brengi/MG-Lab/README.md

# MG-Lab
Producción del Laboratorio Mario Gattafoni

## Objetivos ##
El MG-Lab trabaja con alumnos de colegios técnicos secundarios, bajo
el régimen de práctica profesional supervisada.
Se utilizan tecnologías abiertas y se publican los resultados de cada
práctica.

## Responsables ##
El plantel estable del laboratorio esta formado por Omar Milano y Diego Brengi.

## Nombre del laboratorio ##
El laboratorio se bautiza con ese nombre en honor a Mario Gattafoni quien fue profesor
de Omar y Diego en la secundaria y en la universidad, y dedicó su vida a 
la educación técnica secundaria y universitaria.

## Grupos MG-LAB 2019

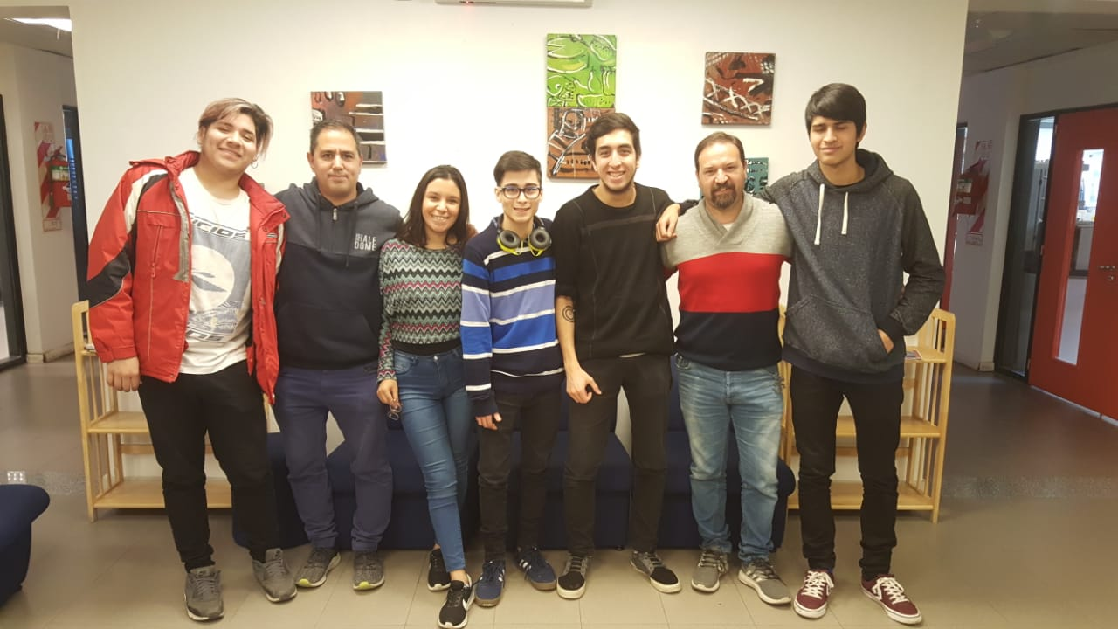
[picture p1: doc/fotos_grupales/2019b.jpg]
Grupo2019b Grupo 2019b

De izquierda a derecha:.

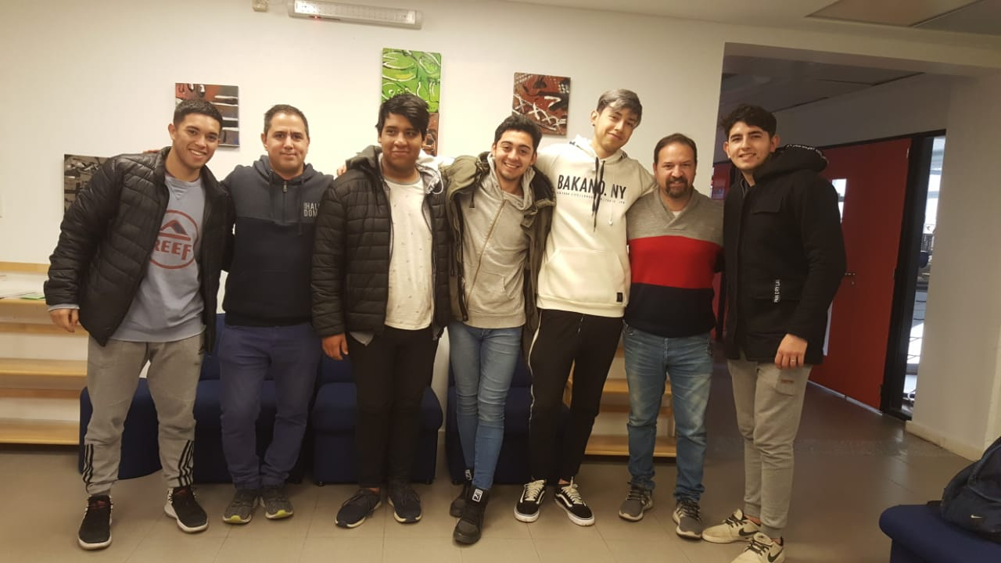
[picture p2: doc/fotos_grupales/2019a.jpg]
Grupo2019a Grupo 2019a

De izquierda a derecha:.

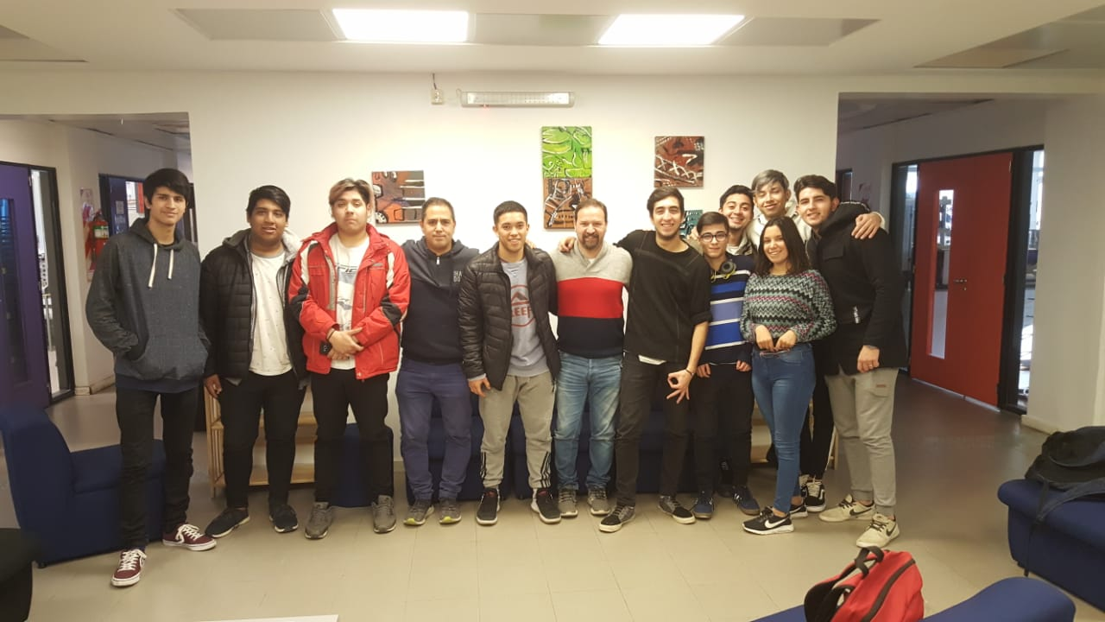
[picture p3: doc/fotos_grupales/2019ab.jpg]
Grupo2019ab Grupo 2019ab

De izquierda a derecha:.

## Grupos MG-LAB 2018

Grupo2018 Grupo 2018
De izquierda a derecha: Omar Milano, ... y Diego Brengi.

## Grupos MG-LAB 2017

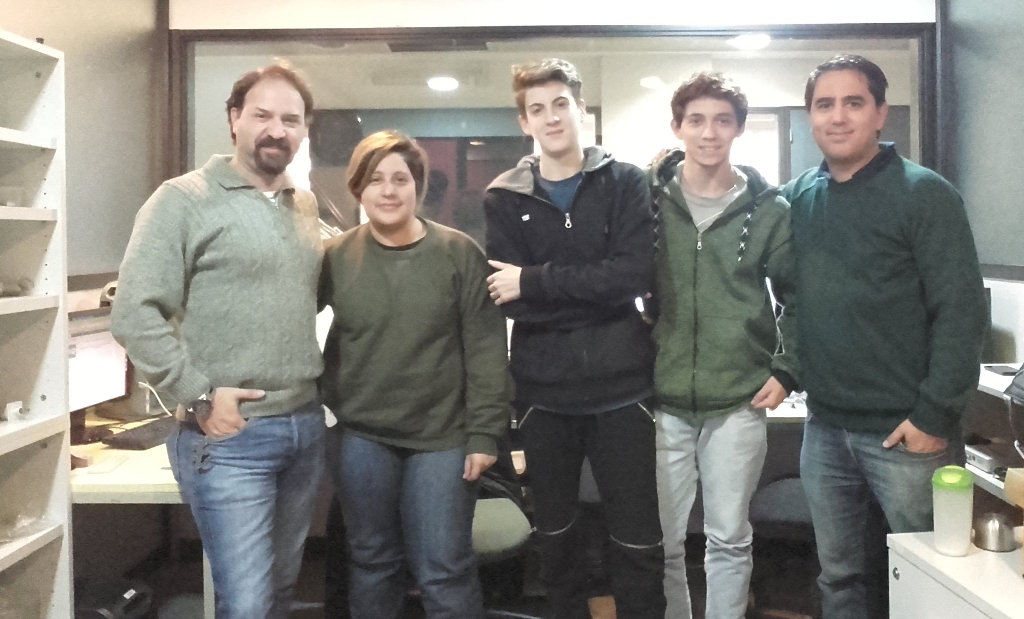
[picture p4: doc/fotos_grupales/MGLAB_Grupo3.jpg]
Grupo3 Grupo 3

De izquierda a derecha: Omar Milano, Delfina Gonzalez, Gonzalo Daniel Magdalena, Nelson Saade y Diego Brengi.

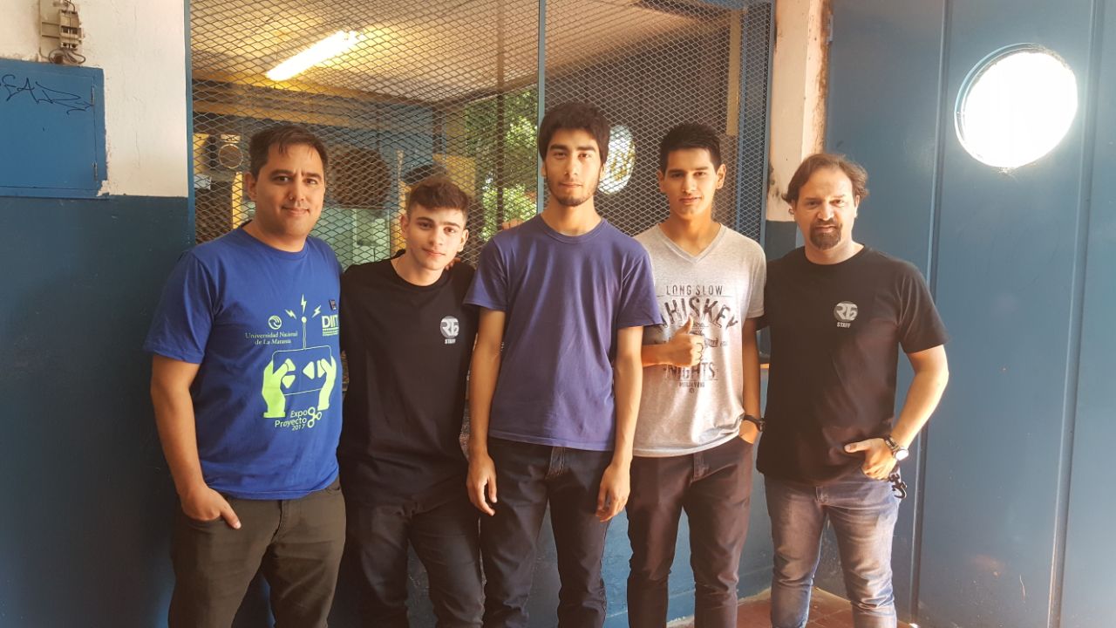
[picture p5: doc/fotos_grupales/MGLAB_Grupo4_2017B.jpg]
Grupo4 Grupo 4

De izquierda a derecha: Diego Brengi, XX1, XX2, XX3 y Omar Milano.

## Grupos MG-LAB 2016

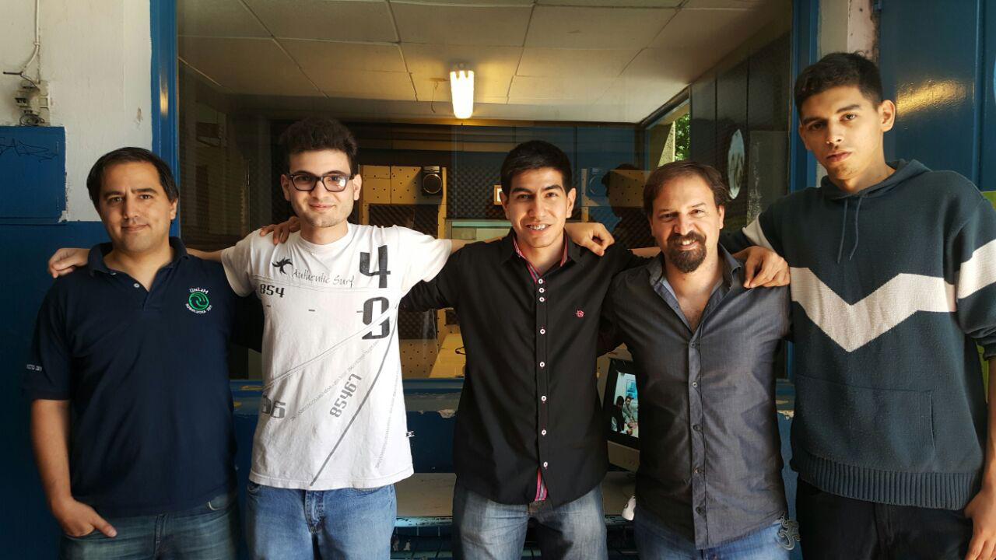
[picture p6: doc/fotos_grupales/MGLAB_Grupo1.jpg]
Grupo1 Grupo 1

De izquierda a derecha: Diego Brengi, Juan Ignacio
Napolillo, Nicolas David Luna, Omar Milano y Leonel Gabriel Costa.

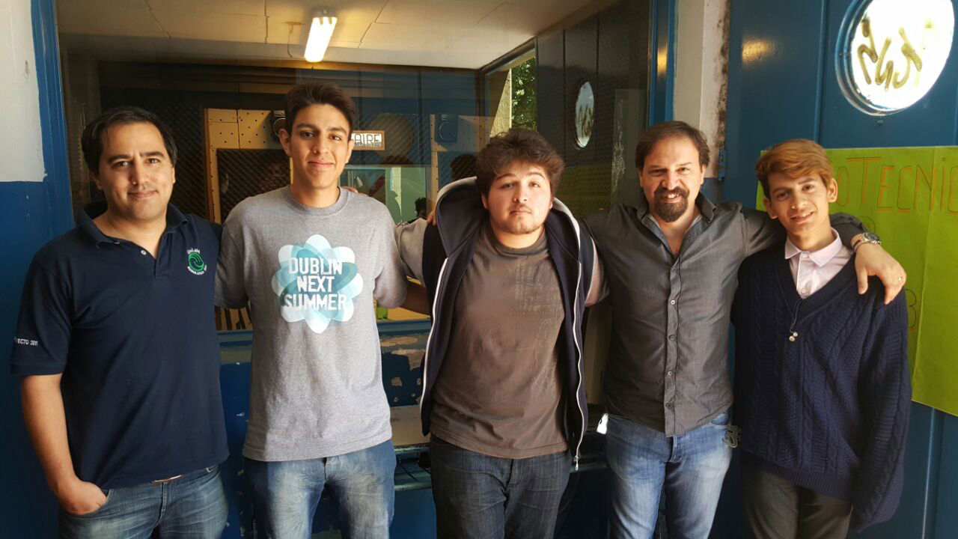
[picture p7: doc/fotos_grupales/MGLAB_Grupo2.jpg]
Grupo2 Grupo 2

De izquierda a derecha: Diego Brengi, Alejandro Franco, Fernando Flores, Omar Milano y Fernando Sosa.
