brengi/MG-Lab/Arduino_SumoRobot/README.md

# SHIELD DE ARDUINO PARA ROBOT SUMO #
 
RESPONSABLE:  
 
## ACTIVIDAD ##
Realizar un una implementación con Arduino que permita controlar un robot 
sumo. Primero con módulos comerciales y cableado y luego si es posible, diseñar uno o 
más shields usando KiCad.
 
## PAUTAS ##
  *  Manejo de dos motores en ambos sentidos, con relés. 
  * Manejo de 4 sensores de línea infrarrojos. 
  * Entrada de dos pulsadores. 
  * Manejo de un relé o salida transistor adicional y posibilidad de manejar un servo 
(puede ser todo el mismo pin). 
  * Posibilidad de conectar uno o dos módulos de ultrasonido FR04. 
  * Considerar alimentación de 12 Volts. 
  * Considerar protecciones en el manejo de potencia: Motores, bobinas de relés y 
servos. 
  * PCBs de simple capa (que se puedan fabricar con plancha). Pueden ser varios 
shields apilables, pero que puedan trabajar todos juntos.  Puede ocupar más área
que el arduino.
