brengi/MG-Lab/Boton_Auxilio/Diagrama_en_bloques/Diagrama_en_bloques.png

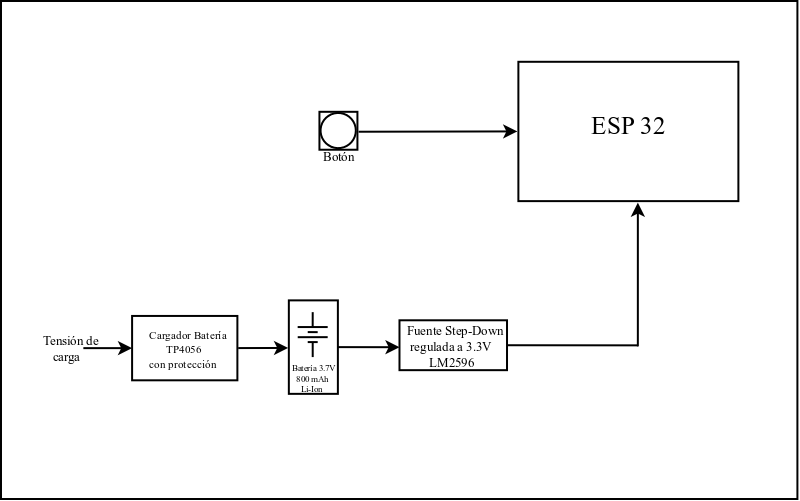
Boton_Auxilio/Diagrama_en_bloques/Diagrama_en_bloques.png
