brengi/MG-Lab/Rolador/PLACA_ROLADOR_Alimentacion/serigrafia.pdf

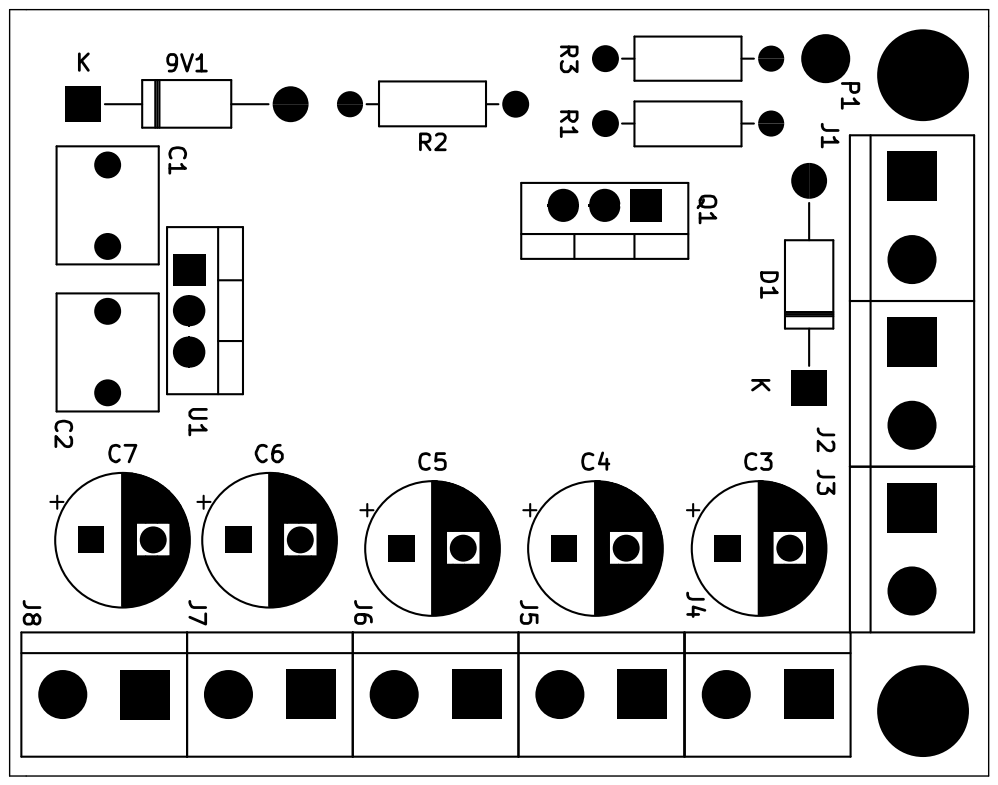
[picture p18: page 1]
