brengi/MG-Lab/(list of files, drawings)

Other design files:
Rolador/PLACA_ROLADOR_Alimentacion/placa de tension rolador.dsn
