brengi/MG-Lab/Rolador/PLACA_ROLADOR_Alimentacion/placa de tension rolador.kicad_pcb

## KiCad design Rolador/PLACA_ROLADOR_Alimentacion/placa de tension rolador.kicad_pcb (2019-07-31)

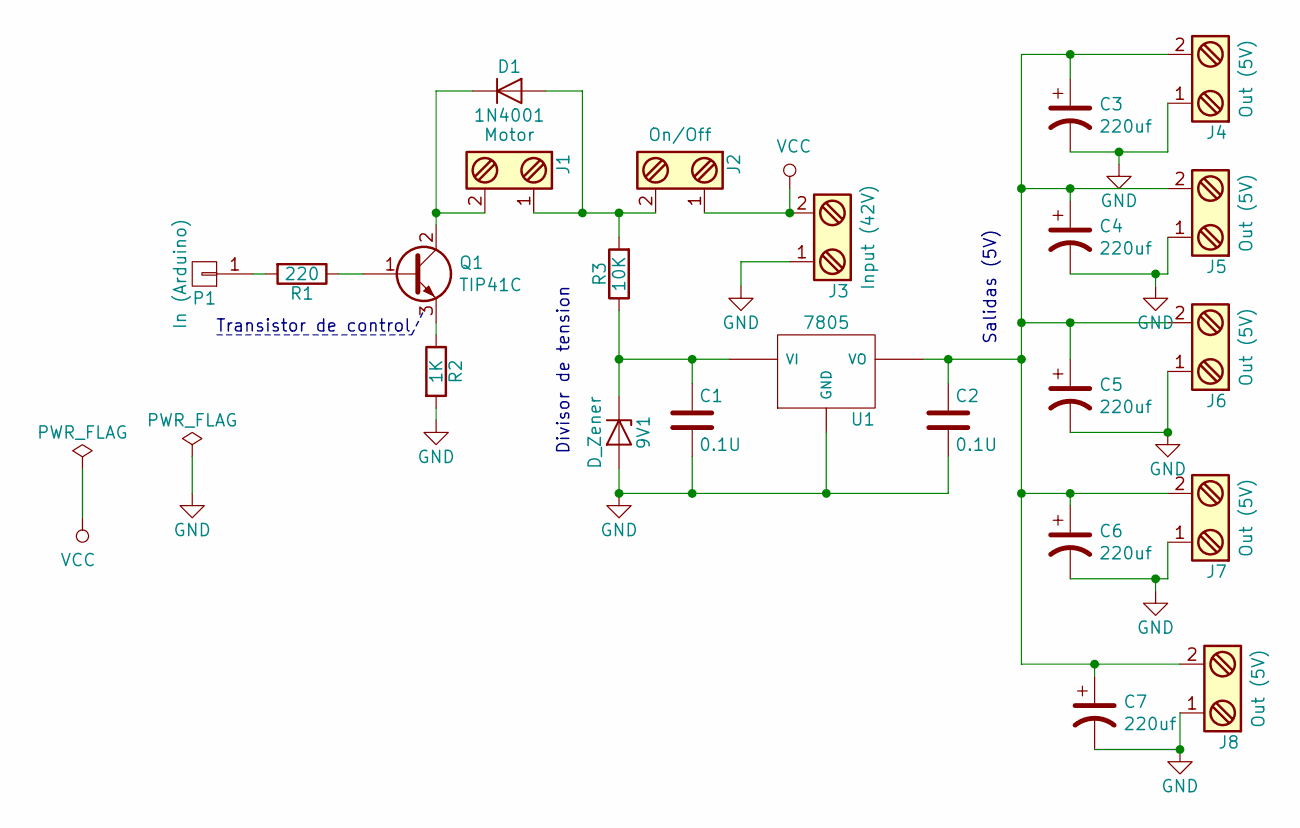
[picture p19: schematic placa de tension rolador.sch, Placa de alimentacion rolador]

Parts:
9V1: D_Zener; D_DO-41_SOD81_P12.70mm_Horizontal
C1, C2: 0.1U; C_Rect_L7.0mm_W6.0mm_P5.00mm
C3, C4, C5, C6, C7: 220uf; CP_Radial_D8.0mm_P3.80mm
D1: 1N4001; D_DO-41_SOD81_P12.70mm_Horizontal
J1: Motor; TerminalBlock_bornier-2_P5.08mm
J2: On/Off; TerminalBlock_bornier-2_P5.08mm
J3: Input (42V); TerminalBlock_bornier-2_P5.08mm
J4, J5, J6, J7, J8: Out (5V); TerminalBlock_bornier-2_P5.08mm
P1: In (Arduino); Pin_D0.7mm_L6.5mm_W1.8mm_FlatFork
Q1: TIP41C; TO-220-3_Vertical
R1: 220; R_Axial_DIN0207_L6.3mm_D2.5mm_P10.16mm_Horizontal
R2: 1K; R_Axial_DIN0207_L6.3mm_D2.5mm_P10.16mm_Horizontal
R3: 10K; R_Axial_DIN0207_L6.3mm_D2.5mm_P10.16mm_Horizontal
U1: 7805; TO-220-3_Vertical

Connections:
GND: 9V1.2 (A), C1.2, C2.2, C3.2, C4.2, C5.2, C6.2, C7.2, J3.1, J4.1, J5.1, J6.1, J7.1, J8.1, R2.2, U1.2 (GND)
unnamed: 9V1.1 (K), C1.1, R3.1, U1.1 (VI)
unnamed: C2.1, C3.1, C4.1, C5.1, C6.1, C7.1, J4.2, J5.2, J6.2, J7.2, J8.2, U1.3 (VO)
unnamed: D1.1 (K), J1.2, Q1.2 (C)
unnamed: D1.2 (A), J1.1, J2.2, R3.2
unnamed: P1.1, R1.2
unnamed: Q1.1 (B), R1.1
unnamed: Q1.3 (E), R2.1
VCC: J2.1, J3.2

Notes on the sheet:
Transistor de control
Divisor de tension
Salidas (5V)

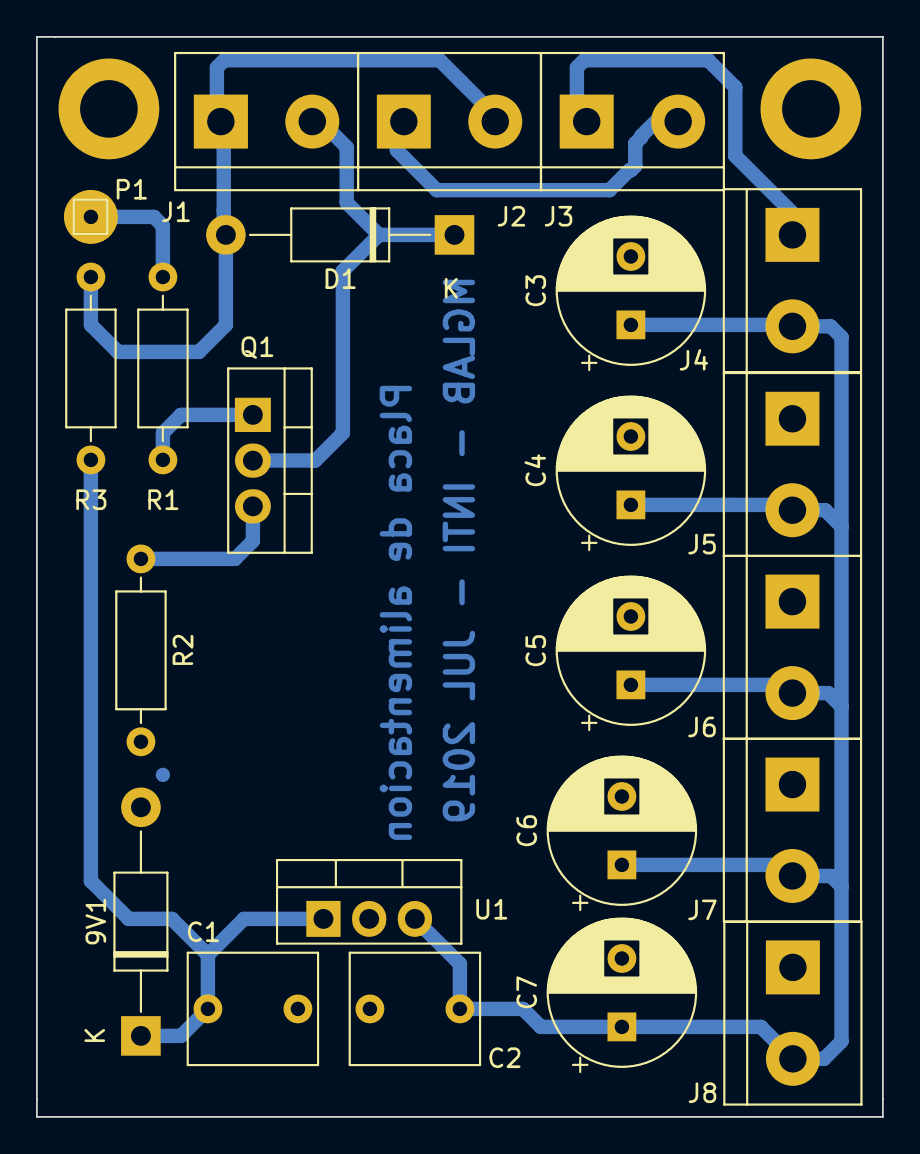
[picture p20: board placa de tension rolador.kicad_pcb from above]

Board: 2 copper layers, 47.0 x 60.0 mm, 25 parts (0 on the bottom side), 9 nets.

Other parts of the board:
H1, H2: .; MountingHole_3.2mm_M3_DIN965_Pad
