brengi/MG-Lab/Arduino_SumoRobot/sumo.kicad_pcb

## KiCad design Arduino_SumoRobot/sumo.kicad_pcb (2016-12-20)

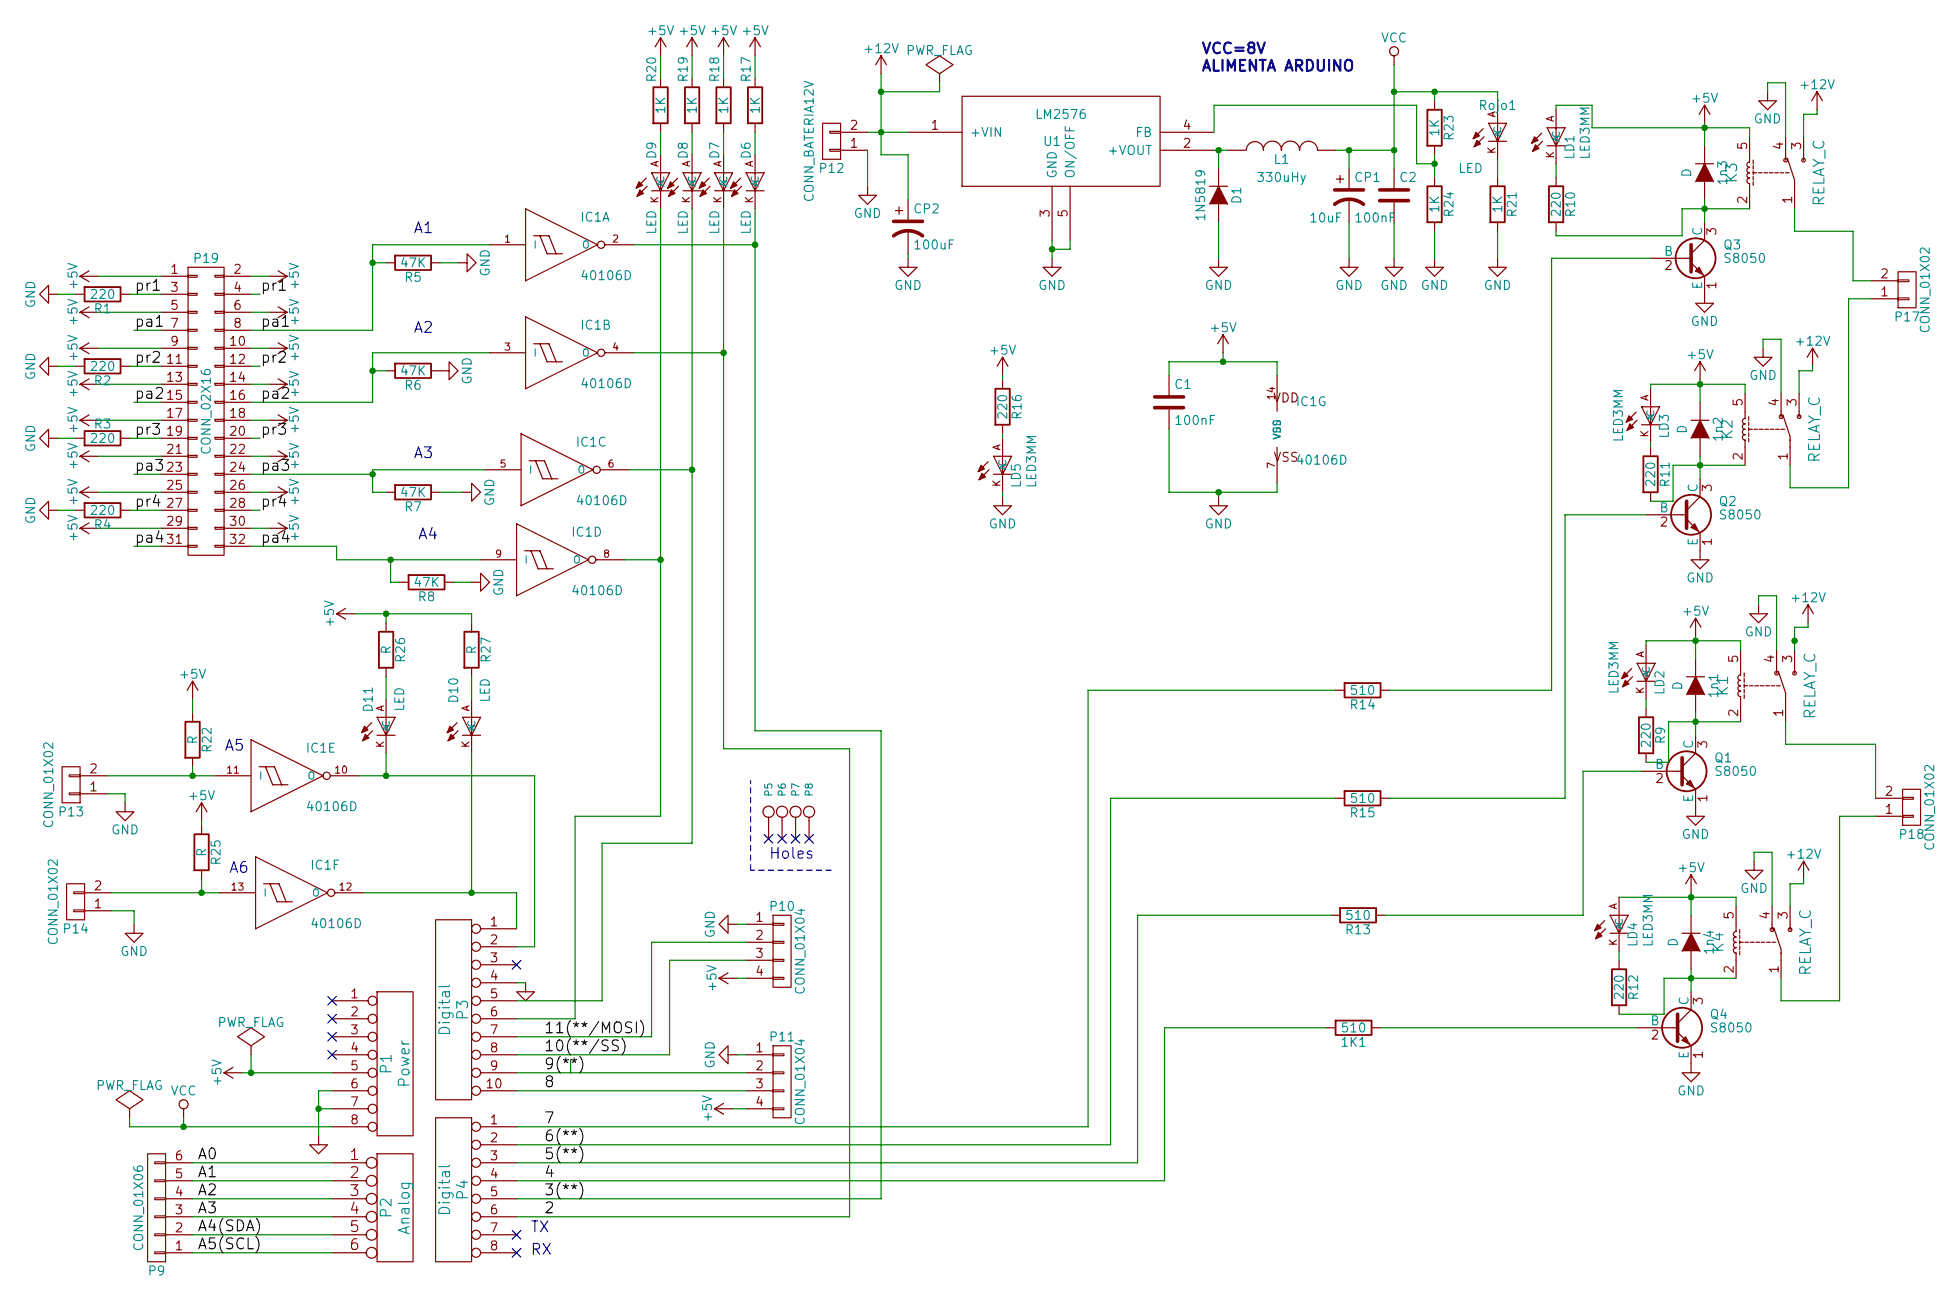
[picture p21: schematic sumo.sch]

Parts:
1K1: 510; Resistor_Horizontal_RM7mm
1n1, 1n2, 1n3, 1n4: D; Diode_DO-41_SOD81_Horizontal_RM10
C1, C2: 100nF; C_Rect_L7_W6_P5
CP1: 10uF; C_Radial_D6.3_L11.2_P2.5
CP2: 100uF; C_Radial_D6.3_L11.2_P2.5
D1: 1N5819; Diode_DO-41_SOD81_Horizontal_RM10
D6, D7, D8, D9, D10, D11: LED; led-LED3MM
IC1: 40106D; DIP-14_W7.62mm_LongPads
K1, K2, K3, K4: RELAY_C; Relay_SANYOU_SRD_Series_Form_C
L1: 330uHy; INDUCTOR_V
LD1, LD2, LD3, LD4, LD5: LED3MM; led-LED3MM
P1: Power; Socket_Strip_Arduino_1x08
P2: Analog; Socket_Strip_Arduino_1x06
P3: Digital; Socket_Strip_Arduino_1x10
P4: Digital; Socket_Strip_Arduino_1x08
P5, P6, P7, P8: CONN_1; Arduino_1pin
P9: CONN_01X06; Pin_Header_Straight_1x06
P10, P11: CONN_01X04; Pin_Header_Straight_1x04
P12: CONN_BATERIA12V; bornier2
P13, P14, P17, P18: CONN_01X02; bornier2
P19: CONN_02X16; Pin_Header_Straight_2x16
Q1, Q2, Q3, Q4: S8050; TO-92_Rugged
R1, R2, R3, R4, R9, R10, R11, R12, R16: 220; Resistor_Horizontal_RM7mm
R5, R6, R7, R8: 47K; Resistor_Horizontal_RM7mm
R13, R14, R15: 510; Resistor_Horizontal_RM7mm
R17, R18, R19, R20, R21, R23, R24: 1K; Resistor_Horizontal_RM7mm
R22, R25, R26, R27: R; Resistor_Horizontal_RM7mm
Rojo1: LED; led-LED3MM
U1: LM2576; TO220-51

Connections:
+5V: 1n1.1 (K), 1n2.1 (K), 1n3.1 (K), 1n4.1 (K), C1.1, IC1.14 (VDD), K1.5, K2.5, K3.5, K4.5, LD1.A, LD2.A, LD3.A, LD4.A, P1.5, P10.4, P11.4, P19.1, P19.2, P19.5, P19.6, P19.9, P19.10, P19.13, P19.14, P19.17, P19.18, P19.21, P19.22, P19.25, P19.26, P19.29, P19.30, R16.1, R17.1, R18.1, R19.1, R20.1, R22.1, R25.1, R26.1, R27.1
+12V: CP2.1, K1.3, K2.3, K3.3, K4.3, P12.2, U1.1 (+VIN)
/2: D7.K (C), IC1.4 (O), P4.6
/3(**): D6.K (C), IC1.2 (O), P4.5
/4: 1K1.2, P4.4
/5(**): P4.3, R13.2
/6(**): P4.2, R15.2
/7: P4.1, R14.2
/8: P3.10, P11.3
/9(**): P3.9, P11.2
/10(**/SS): P3.8, P10.3
/11(**/MOSI): P3.7, P10.2
/A0: P2.1, P9.6
/A1: P2.2, P9.5
/A2: P2.3, P9.4
/A3: P2.4, P9.3
/A4(SDA): P2.5, P9.2
/A5(SCL): P2.6, P9.1
/pa1: IC1.1 (I), P19.7, P19.8, R5.2
/pa2: IC1.3 (I), P19.15, P19.16, R6.2
/pa3: IC1.5 (I), P19.23, P19.24, R7.2
/pa4: IC1.9 (I), P19.31, P19.32, R8.2
/pr1: P19.3, P19.4, R1.1
/pr2: P19.11, P19.12, R2.1
/pr3: P19.19, P19.20, R3.1
/pr4: P19.27, P19.28, R4.1
GND: C1.2, C2.2, CP1.2, CP2.2, D1.2 (A), IC1.7 (VSS), K1.4, K2.4, K3.4, K4.4, LD5.K (C), P1.6, P1.7, P3.4, P10.1, P11.1, P12.1, P13.1, P14.1, Q1.1 (E), Q2.1 (E), Q3.1 (E), Q4.1 (E), R1.2, R2.2, R3.2, R4.2, R5.1, R6.1, R7.1, R8.1, R21.2, R24.2, U1.3 (GND), U1.5 (ON/OFF)
unnamed: 1K1.1, Q4.2 (B)
unnamed: 1n1.2 (A), K1.2, Q1.3 (C), R9.2
unnamed: 1n2.2 (A), K2.2, Q2.3 (C), R11.2
unnamed: 1n3.2 (A), K3.2, Q3.3 (C), R10.2
unnamed: 1n4.2 (A), K4.2, Q4.3 (C), R12.2
unnamed: D1.1 (K), L1.1, U1.2 (+VOUT)
unnamed: D6.A, R17.2
unnamed: D7.A, R18.2
unnamed: D8.A, R19.2
unnamed: D8.K (C), IC1.6 (O), P3.5
unnamed: D9.A, R20.2
unnamed: D9.K (C), IC1.8 (O), P3.6
unnamed: D10.A, R27.2
unnamed: D10.K (C), IC1.12 (O), P3.1
unnamed: D11.A, R26.2
unnamed: D11.K (C), IC1.10 (O), P3.2
unnamed: IC1.11 (I), P13.2, R22.2
unnamed: IC1.13 (I), P14.2, R25.2
unnamed: K1.1, P18.2
unnamed: K2.1, P17.1
unnamed: K3.1, P17.2
unnamed: K4.1, P18.1
unnamed: LD1.K (C), R10.1
unnamed: LD2.K (C), R9.1
unnamed: LD3.K (C), R11.1
unnamed: LD4.K (C), R12.1
unnamed: LD5.A, R16.2
unnamed: Q1.2 (B), R13.1
unnamed: Q2.2 (B), R15.1
unnamed: Q3.2 (B), R14.1
unnamed: R21.1, Rojo1.K (C)
unnamed: R23.2, R24.1, U1.4 (FB)
VCC: C2.1, CP1.1, L1.2, P1.8, R23.1, Rojo1.A

Notes on the sheet:
Holes
VCC=8V ALIMENTA ARDUINO

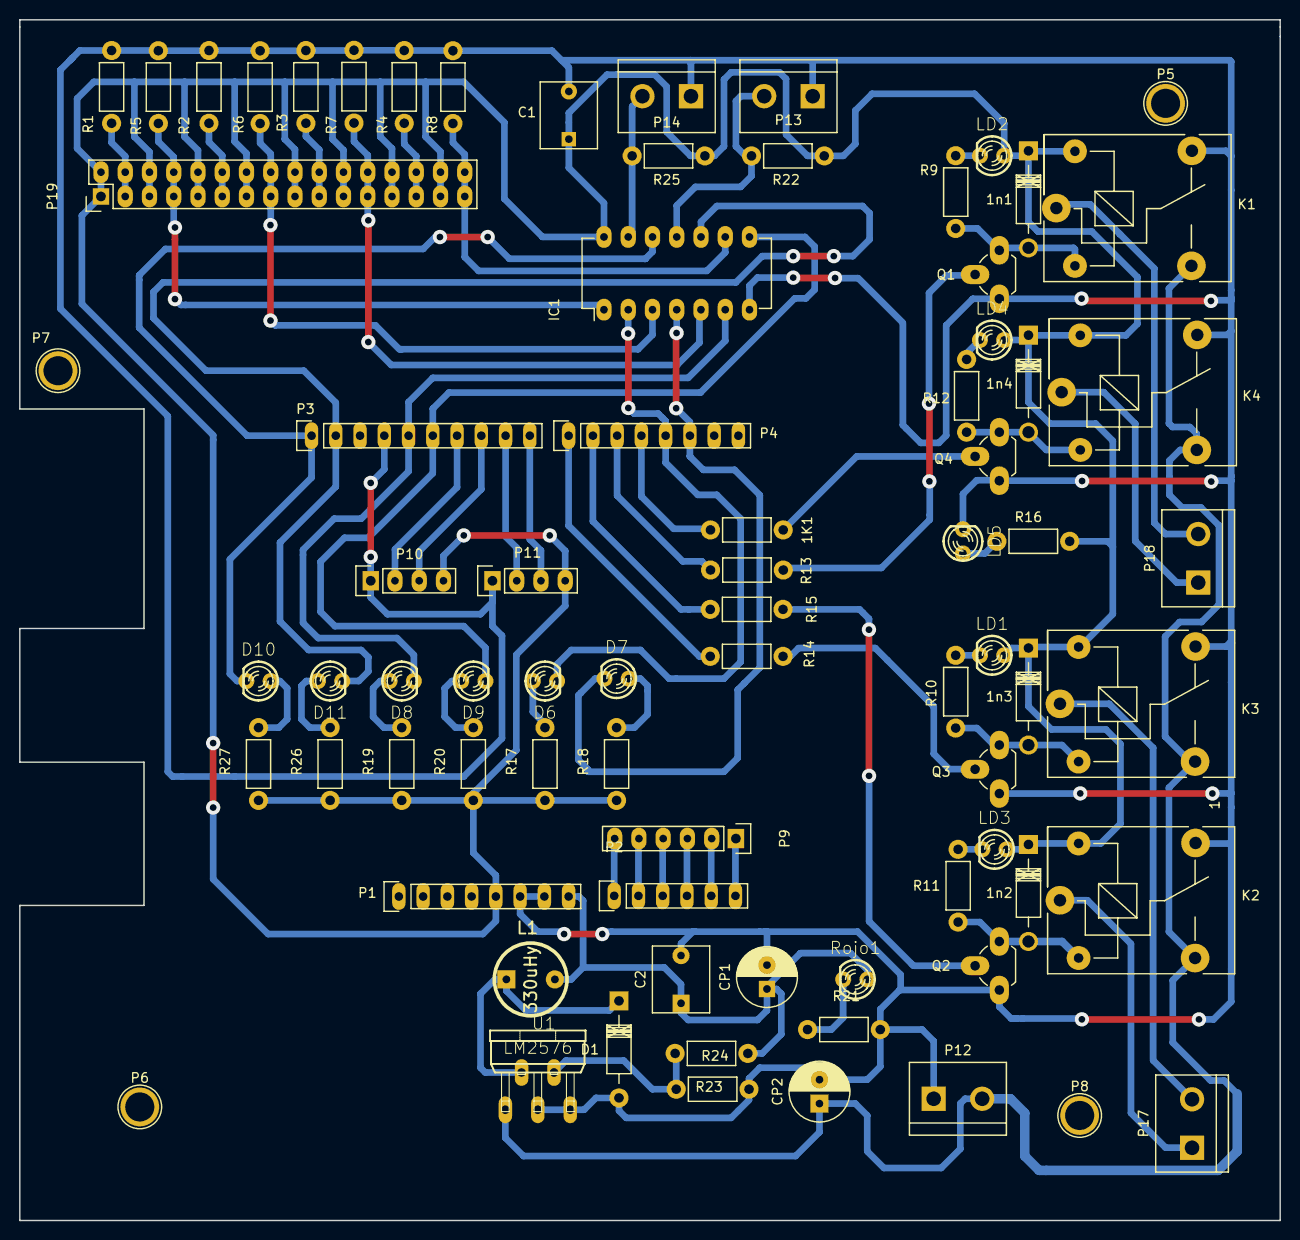
[picture p22: board sumo.kicad_pcb from above]

Board: 2 copper layers, 132.0 x 125.8 mm, 77 parts (0 on the bottom side), 60 nets.
