brengi/MG-Lab/Arduino_Acceso_lab/pcb/shield.kicad_pcb

## KiCad design Arduino_Acceso_lab/pcb/shield.kicad_pcb (2016-12-20)

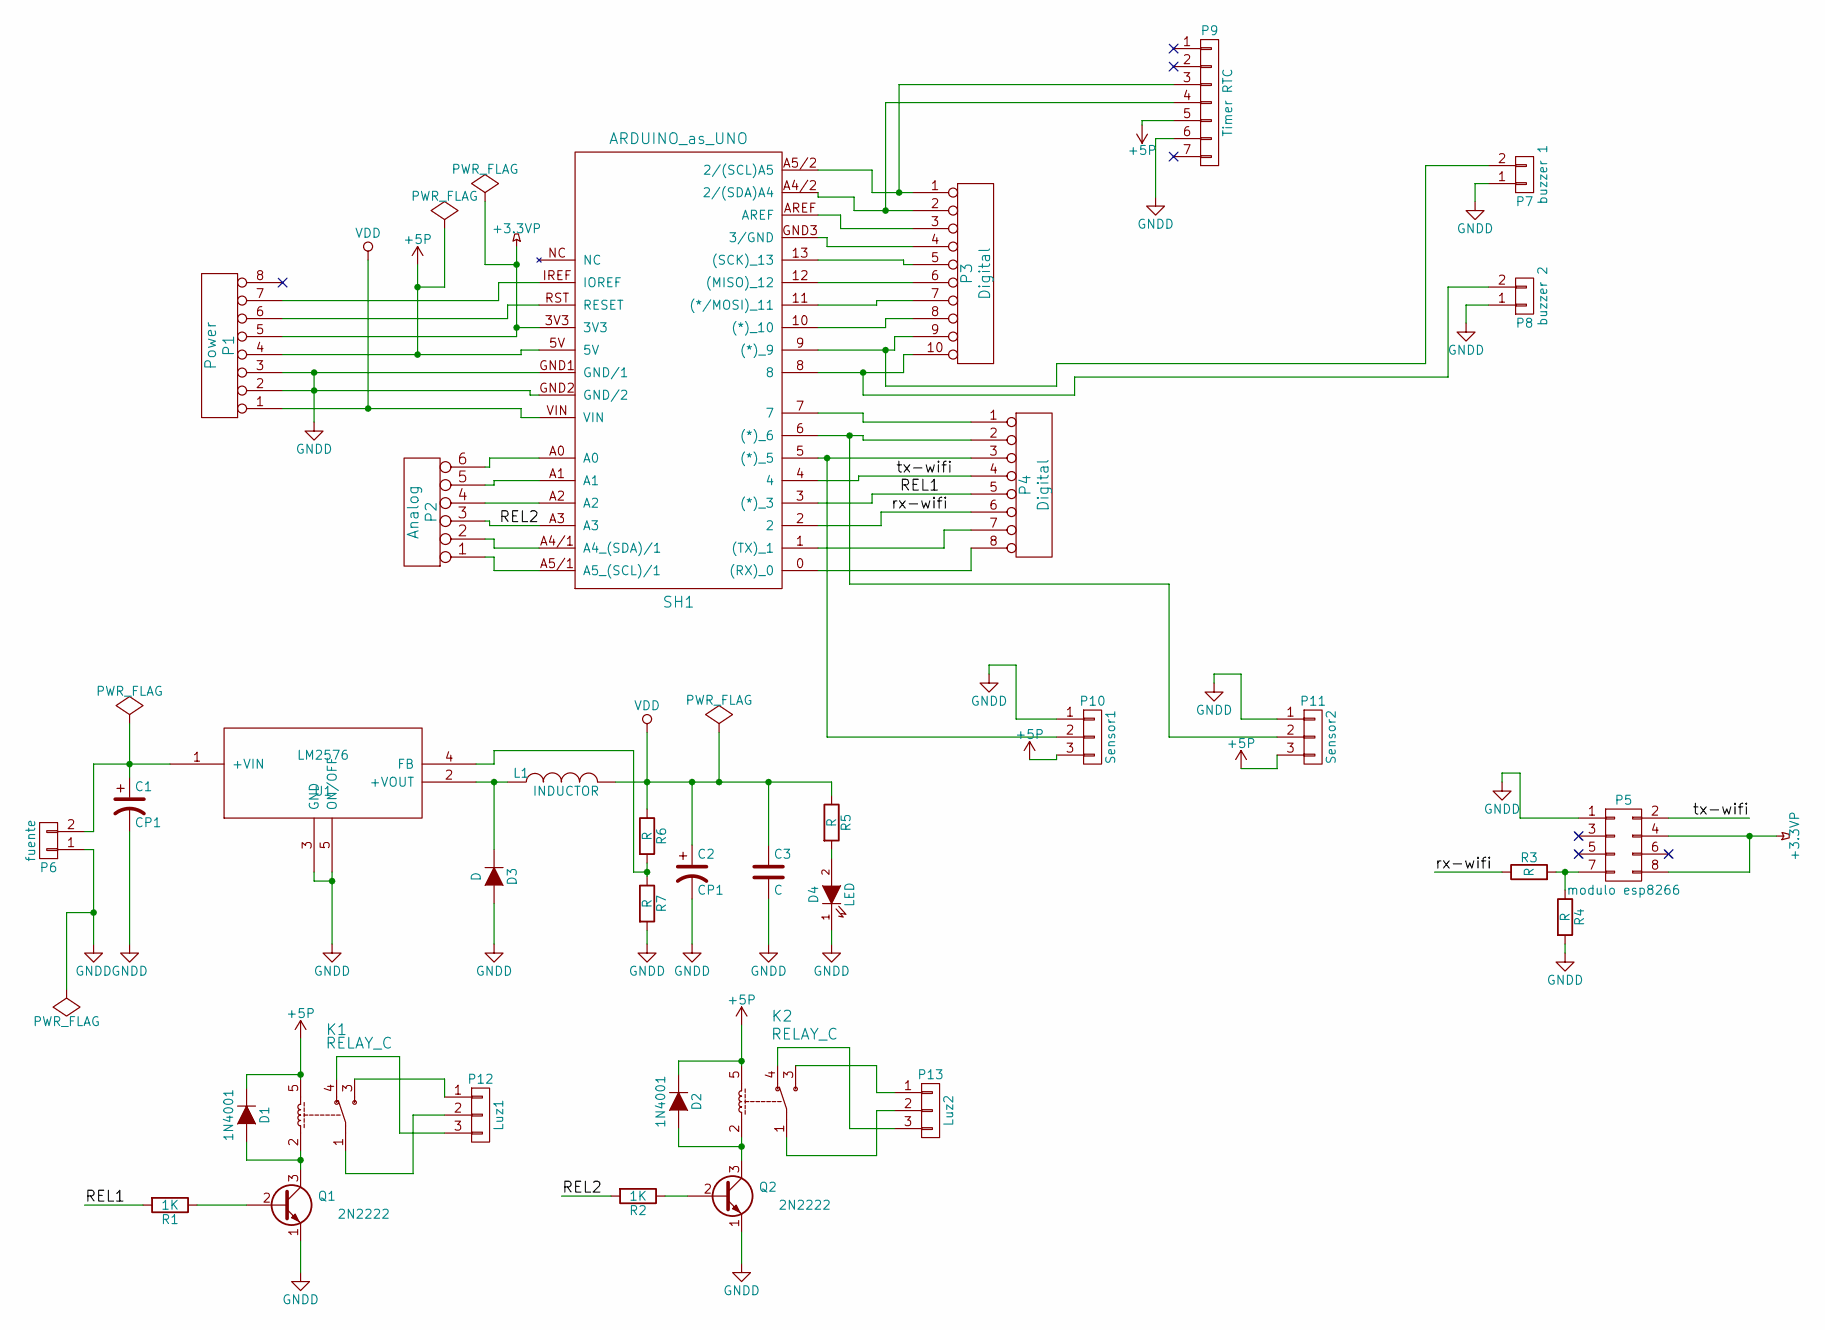
[picture p23: schematic shield.sch, shield sist. monitoreo]

Parts:
C1, C2: CP1; C_Rect_L7.5_W6.5_P5
C3: C; C_Rect_L7.5_W6.5_P5
D1, D2: 1N4001; Diode_DO-35_SOD27_Horizontal_RM10
D3: D; Diode_DO-35_SOD27_Horizontal_RM10
D4: LED; LED-3MM
K1, K2: RELAY_C; Relay_C
L1: INDUCTOR; INDUCTOR_V
P1: Power; Socket_Strip_Straight_1x08
P2: Analog; Socket_Strip_Straight_1x06
P3: Digital; Socket_Strip_Straight_1x10
P4: Digital; Socket_Strip_Straight_1x08
P5: modulo esp8266; Socket_Strip_Straight_2x04
P6: fuente; bornier2
P7: buzzer 1; Pin_Header_Straight_1x02
P8: buzzer 2; Pin_Header_Straight_1x02
P9: Timer RTC; Socket_Strip_Straight_1x07
P10: Sensor1; BORNERA3
P11: Sensor2; BORNERA3
P12: Luz1; BORNERA3
P13: Luz2; BORNERA3
Q1, Q2: 2N2222; TO92-L21
R1, R2: 1K; Resistor_Horizontal_RM7mm
R3, R4, R5, R6, R7: R; Resistor_Horizontal_RM7mm
SH1: ARDUINO_as_UNO; ARDUINO_as_UNO_R3
U1: LM2576; Pentawatt_Neutral_Staggered_Verical_TO220-5-T05D

Connections:
+3.3VP: P1.5, P5.4, P5.8, SH1.3V3
+5P: D1.1 (K), D2.1 (K), K1.5, K2.5, P1.4, P9.5, P10.3, P11.3, SH1.5V
/REL1: P4.5, R1.2, SH1.3 ((*)_3)
/REL2: P2.3, R2.2, SH1.A3
/rx-wifi: P4.6, R3.1, SH1.2
/tx-wifi: P4.4, P5.2, SH1.4
GNDD: C1.2, C2.2, C3.2, D3.2 (A), D4.1 (K), P1.2, P1.3, P5.1, P6.1, P7.1, P8.1, P9.6, P10.1, P11.1, Q1.1 (E), Q2.1 (E), R4.2, R7.2, SH1.GND1 (GND/1), SH1.GND2 (GND/2), U1.3 (GND), U1.5 (ON/OFF)
unnamed: C1.1, P6.2, U1.1 (+VIN)
unnamed: D1.2 (A), K1.2, Q1.3 (C)
unnamed: D2.2 (A), K2.2, Q2.3 (C)
unnamed: D3.1 (K), L1.1, U1.2 (+VOUT)
unnamed: D4.2 (A), R5.2
unnamed: K1.1, P12.2
unnamed: K1.3, P12.1
unnamed: K1.4, P12.3
unnamed: K2.1, P13.2
unnamed: K2.3, P13.1
unnamed: K2.4, P13.3
unnamed: P1.6, SH1.RST (RESET)
unnamed: P1.7, SH1.IREF (IOREF)
unnamed: P2.1, SH1.A5/1 (A5_(SCL)/1)
unnamed: P2.2, SH1.A4/1 (A4_(SDA)/1)
unnamed: P2.4, SH1.A2
unnamed: P2.5, SH1.A1
unnamed: P2.6, SH1.A0
unnamed: P3.1, P9.3, SH1.A5/2 (2/(SCL)A5)
unnamed: P3.2, P9.4, SH1.A4/2 (2/(SDA)A4)
unnamed: P3.3, SH1.AREF
unnamed: P3.4, SH1.GND3 (3/GND)
unnamed: P3.5, SH1.13 ((SCK)_13)
unnamed: P3.6, SH1.12 ((MISO)_12)
unnamed: P3.7, SH1.11 ((*/MOSI)_11)
unnamed: P3.8, SH1.10 ((*)_10)
unnamed: P3.9, P7.2, SH1.9 ((*)_9)
unnamed: P3.10, P8.2, SH1.8
unnamed: P4.1, SH1.7
unnamed: P4.7, SH1.1 ((TX)_1)
unnamed: P4.8, SH1.0 ((RX)_0)
unnamed: P5.7, R3.2, R4.1
unnamed: P4.3, P10.2, SH1.5 ((*)_5)
unnamed: P4.2, P11.2, SH1.6 ((*)_6)
unnamed: Q1.2 (B), R1.1
unnamed: Q2.2 (B), R2.1
unnamed: R6.2, R7.1, U1.4 (FB)
VDD: C2.1, C3.1, L1.2, P1.1, R5.1, R6.1, SH1.VIN

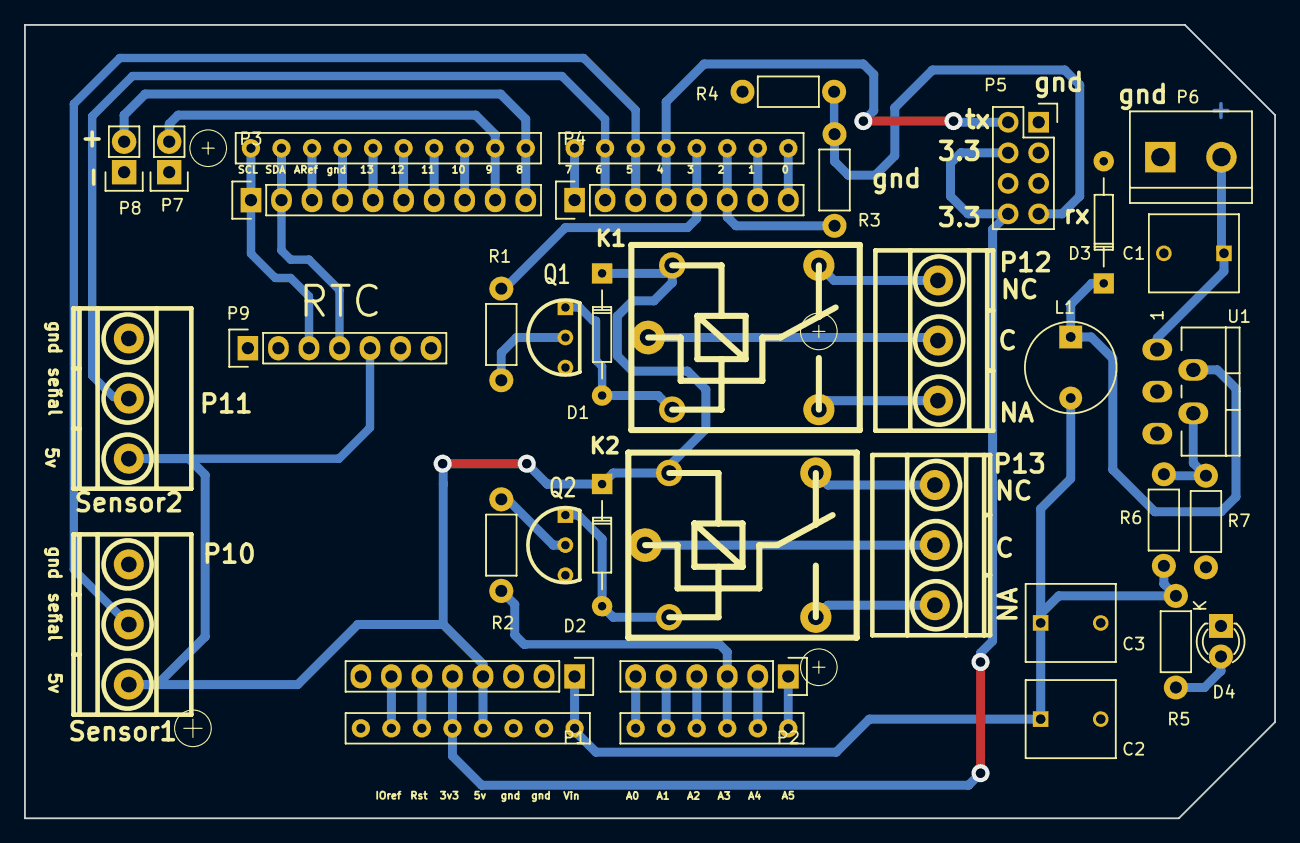
[picture p24: board shield.kicad_pcb from above]

Board: 2 copper layers, 104.0 x 66.0 mm, 34 parts (0 on the bottom side), 45 nets.
