brengi/MG-Lab/Arduino_Acceso_lab/pcb_expo/pcb.kicad_pcb

## KiCad design Arduino_Acceso_lab/pcb_expo/pcb.kicad_pcb (2016-11-08)

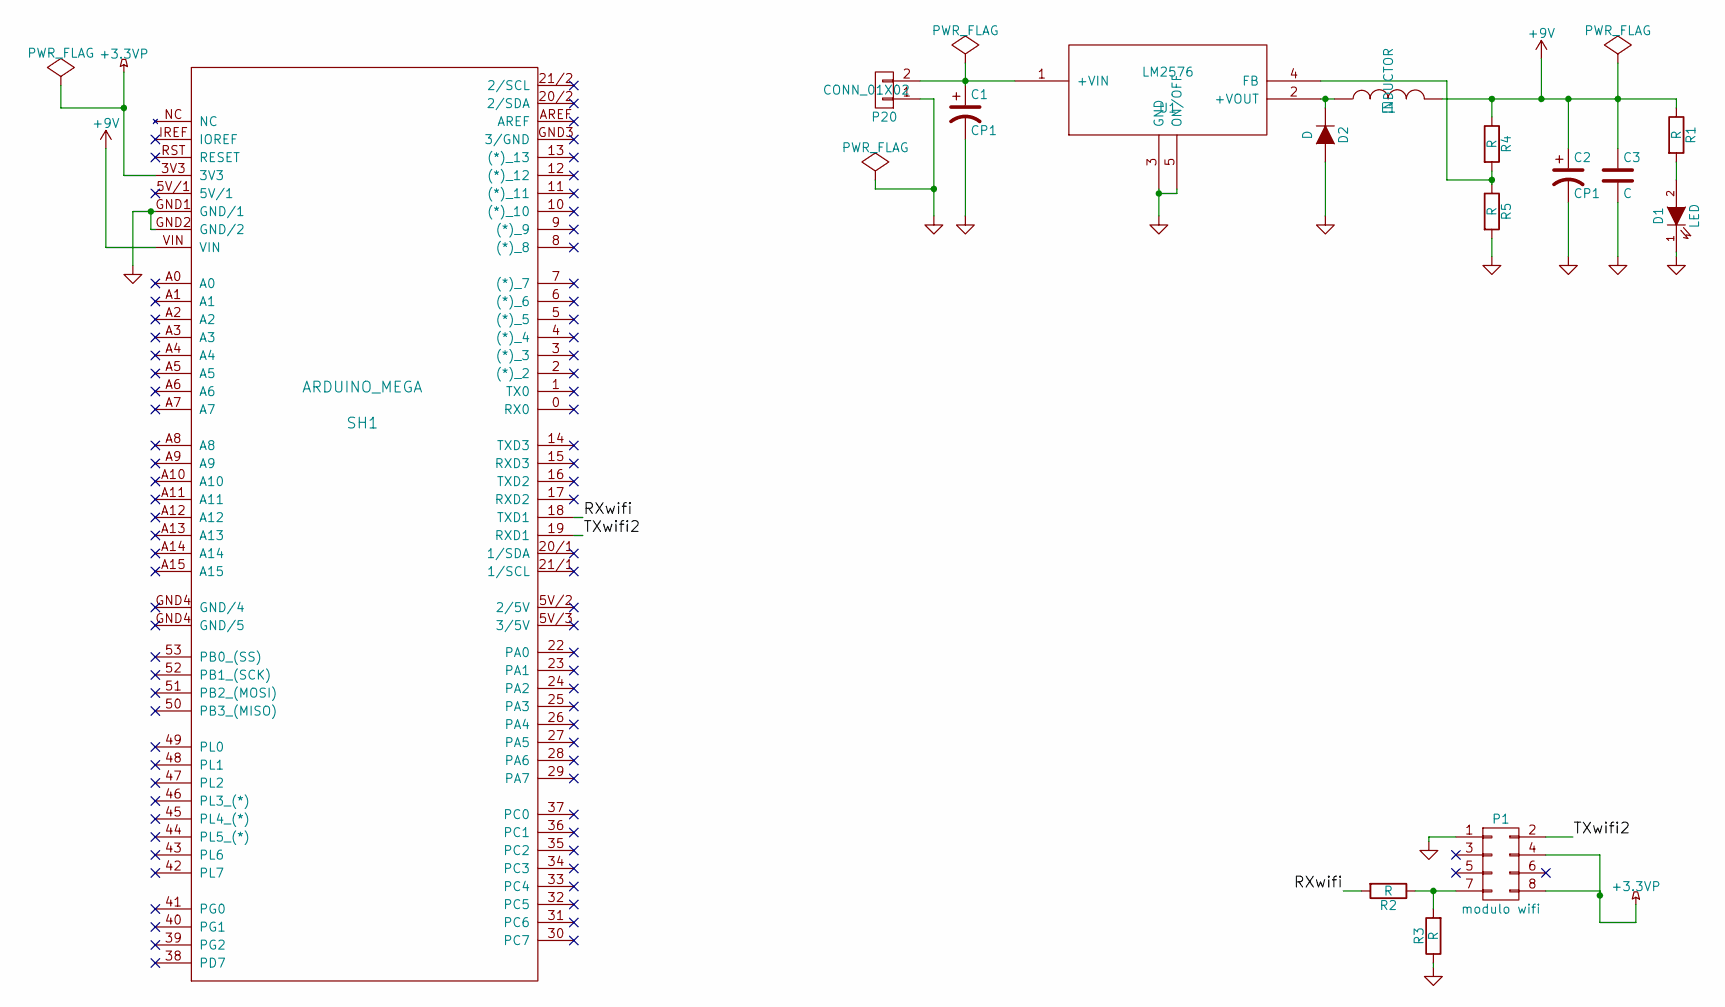
[picture p25: schematic pcb.sch]

Parts:
C1, C2: CP1; C_Rect_L7.5_W6.5_P5
C3: C; C_Rect_L7.5_W6.5_P5
D1: LED; LED-5MM
D2: D; Diode_DO-35_SOD27_Horizontal_RM10
L1: INDUCTOR; INDUCTOR_V
P1: modulo wifi; Socket_Strip_Straight_2x04
P20: CONN_01X02; bornier2
R1, R2, R3, R4, R5: R; Resistor_Horizontal_RM10mm
SH1: ARDUINO_MEGA; ARDUINO_MEGA_2560_R3_ELL
U1: LM2576; Pentawatt_Neutral_Staggered_Verical_TO220-5-T05D

Connections:
+3.3VP: P1.4, P1.8, SH1.3V3
+9V: C2.1, C3.1, L1.2, R1.1, R4.1, SH1.VIN
/RXwifi: R2.2, SH1.18 (TXD1)
/TXwifi2: P1.2, SH1.19 (RXD1)
GND: C1.2, C2.2, C3.2, D1.1 (K), D2.2 (A), P1.1, P20.1, R3.1, R5.2, SH1.GND1 (GND/1), SH1.GND2 (GND/2), U1.3 (GND), U1.5 (ON/OFF)
unnamed: C1.1, P20.2, U1.1 (+VIN)
unnamed: D1.2 (A), R1.2
unnamed: D2.1 (K), L1.1, U1.2 (+VOUT)
unnamed: P1.7, R2.1, R3.2
unnamed: R4.2, R5.1, U1.4 (FB)

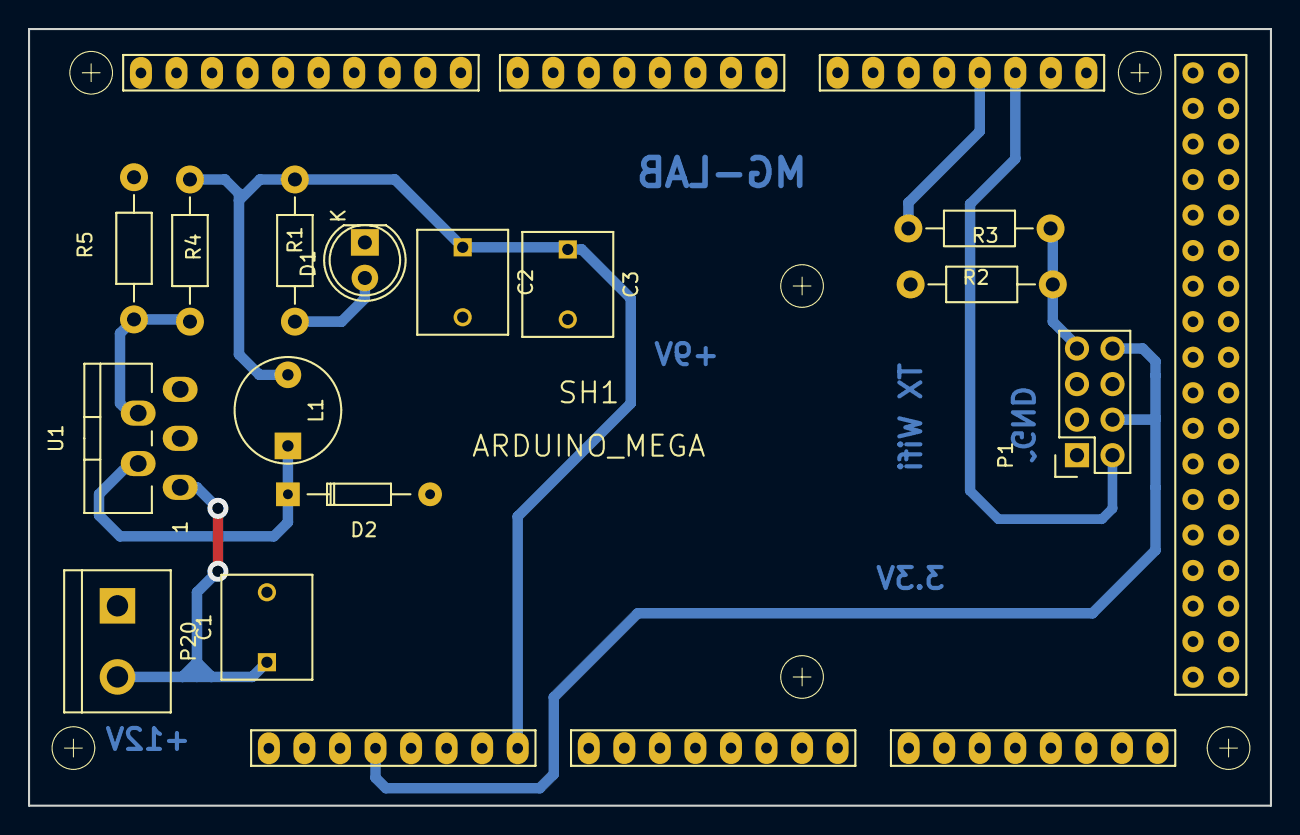
[picture p26: board pcb.kicad_pcb from above]

Board: 2 copper layers, 88.8 x 55.5 mm, 15 parts (0 on the bottom side), 10 nets.
