brengi/MG-Lab/EDU-CIAA_Poncho_SumoRobot/PonchoSumoRobot.kicad_pcb

## KiCad design EDU-CIAA_Poncho_SumoRobot/PonchoSumoRobot.kicad_pcb (2016-11-03)

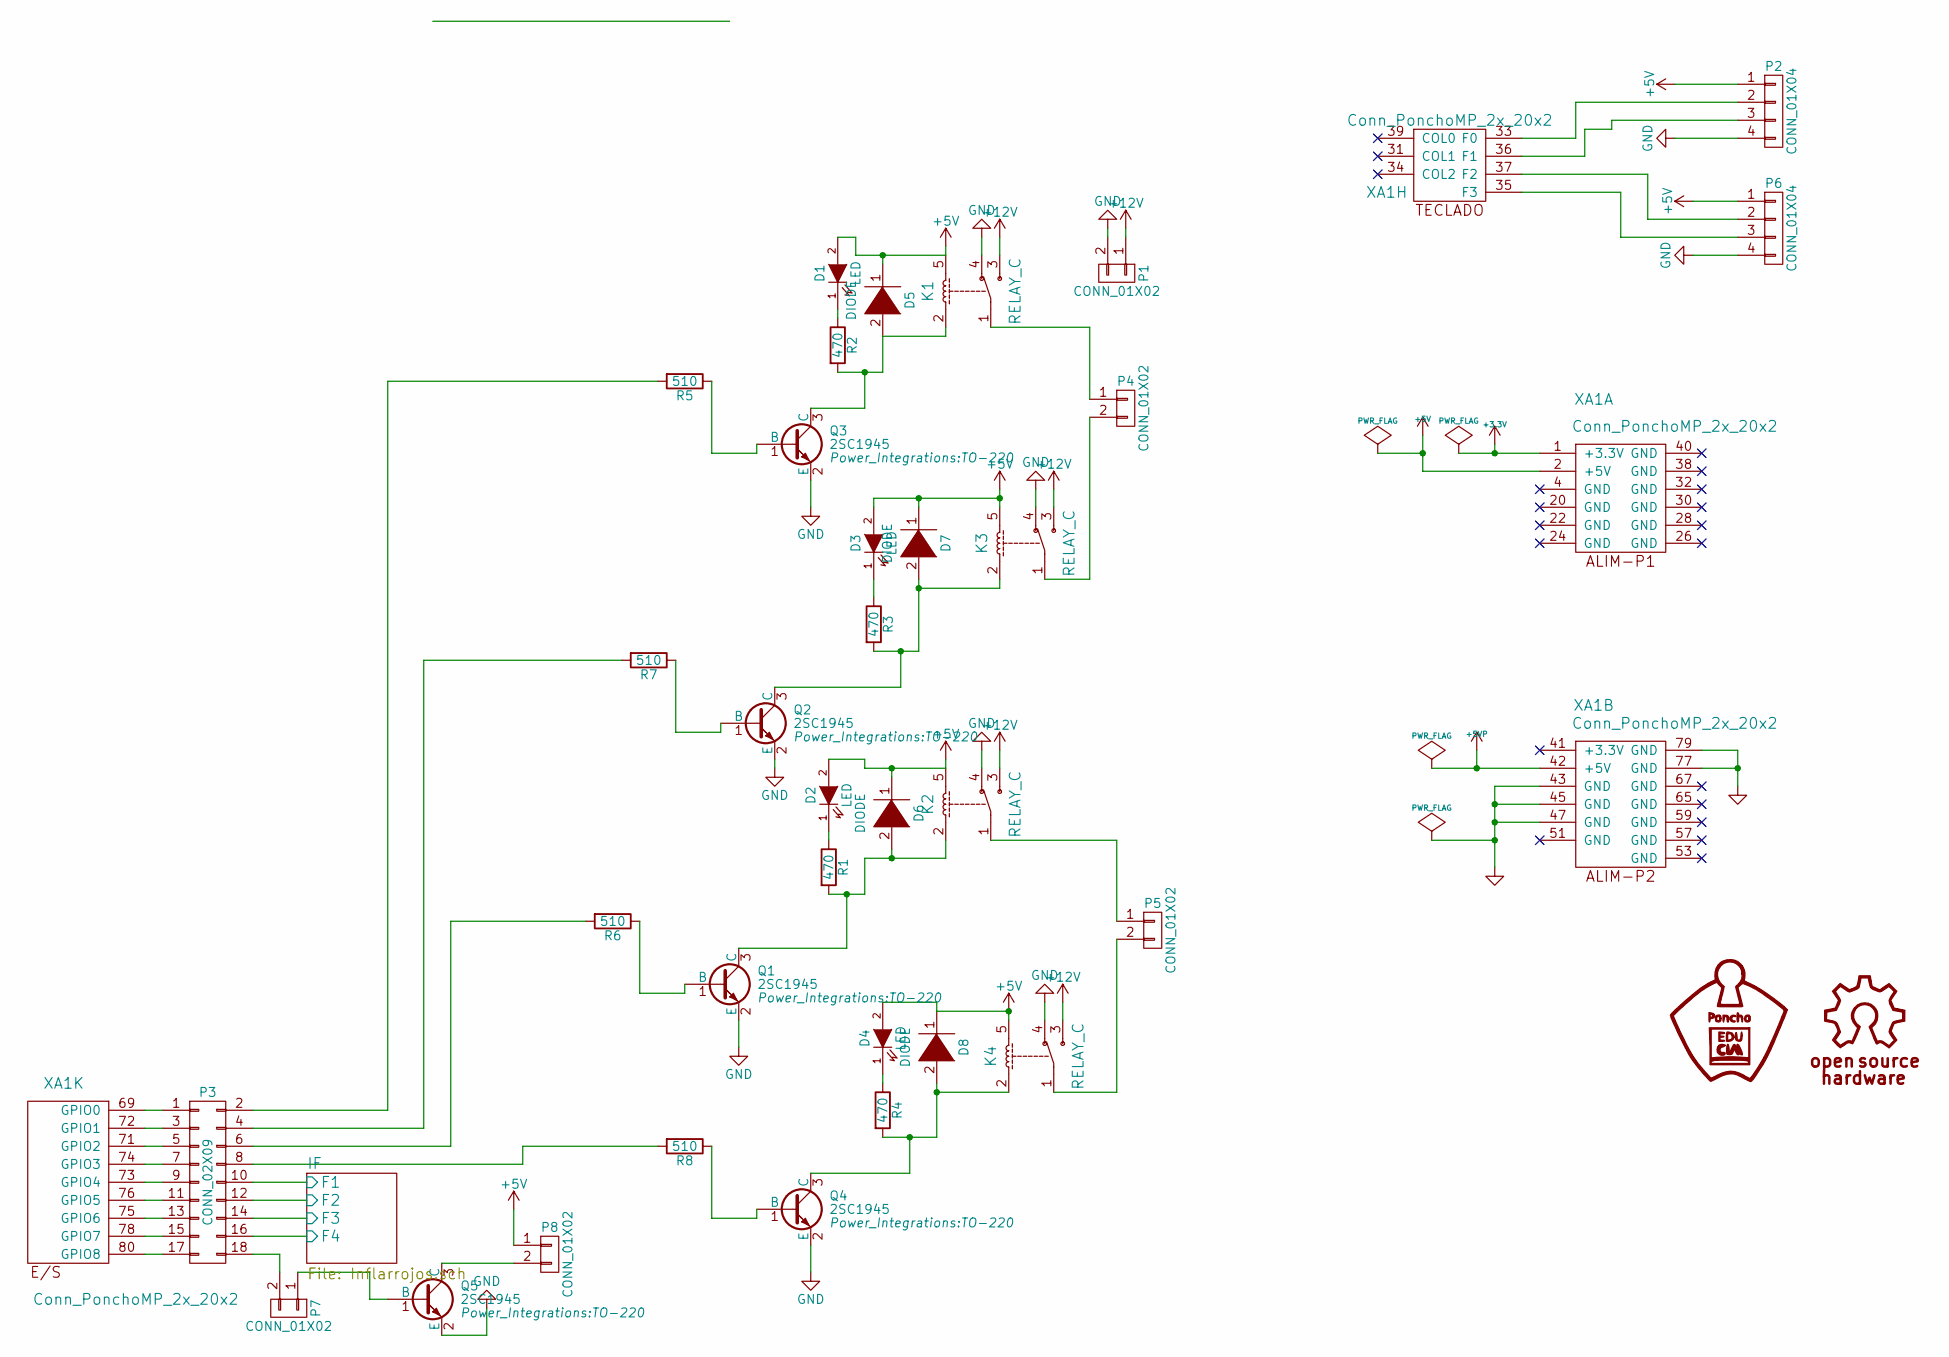
[picture p27: schematic PonchoSumoRobot.sch, Sumo Robot]

Parts:
D1, D2, D3, D4: LED; LED-3MM
D5, D6, D7, D8: DIODE; Diode_DO-41_SOD81_Horizontal_RM10
K1, K2, K3, K4: RELAY_C; Relay_SANYOU_SRD_Series_Form_C
P1, P4, P5: CONN_01X02; bornier2
P2, P6: CONN_01X04; Pin_Header_Straight_1x04
P3: CONN_02X09; Pin_Header_Straight_2x09
P7, P8: CONN_01X02; Pin_Header_Straight_1x02
Q1, Q2, Q3, Q4, Q5: 2SC1945; TO-220
R1, R2, R3, R4: 470; Resistor_Horizontal_RM7mm
R5, R6, R7, R8: 510; Resistor_Horizontal_RM7mm
XA1: Conn_PonchoMP_2x_20x2; Conn_Poncho_SinBorde

Connections:
+3V3: XA1.1 (+3.3V)
+5V: D1.2 (A), D2.2 (A), D3.2 (A), D4.2 (A), D5.1 (K), D6.1 (K), D7.1 (K), D8.1 (K), K1.5, K2.5, K3.5, K4.5, P2.1, P6.1, P8.1, XA1.2 (+5V); also elsewhere on the board
+5VP: XA1.42 (+5V)
+12V: K1.3, K2.3, K3.3, K4.3, P1.1
/IF/F1: P3.10; also elsewhere on the board
/IF/F2: P3.12; also elsewhere on the board
/IF/F3: P3.14; also elsewhere on the board
/IF/F4: P3.16; also elsewhere on the board
unnamed: D1.1 (K), R2.1
unnamed: D2.1 (K), R1.1
unnamed: D3.1 (K), R3.1
unnamed: D4.1 (K), R4.1
unnamed: D5.2 (A), K1.2, Q3.3 (C), R2.2
unnamed: D6.2 (A), K2.2, Q1.3 (C), R1.2
unnamed: D7.2 (A), K3.2, Q2.3 (C), R3.2
unnamed: D8.2 (A), K4.2, Q4.3 (C), R4.2
unnamed: K1.1, P4.1
unnamed: K2.1, P5.1
unnamed: K3.1, P4.2
unnamed: K4.1, P5.2
unnamed: P2.2, XA1.33 (F0)
unnamed: P2.3, XA1.36 (F1)
unnamed: P3.1, XA1.69 (GPIO0)
unnamed: P3.2, R5.2
unnamed: P3.3, XA1.72 (GPIO1)
unnamed: P3.4, R7.2
unnamed: P3.5, XA1.71 (GPIO2)
unnamed: P3.6, R6.2
unnamed: P3.7, XA1.74 (GPIO3)
unnamed: P3.8, R8.2
unnamed: P3.9, XA1.73 (GPIO4)
unnamed: P3.11, XA1.76 (GPIO5)
unnamed: P3.13, XA1.75 (GPIO6)
unnamed: P3.15, XA1.78 (GPIO7)
unnamed: P3.17, XA1.80 (GPIO8)
unnamed: P3.18, P7.2
unnamed: P6.2, XA1.37 (F2)
unnamed: P6.3, XA1.35 (F3)
unnamed: P7.1, Q5.1 (B)
unnamed: P8.2, Q5.3 (C)
unnamed: Q1.1 (B), R6.1
unnamed: Q2.1 (B), R7.1
unnamed: Q3.1 (B), R5.1
unnamed: Q4.1 (B), R8.1
