brengi/MG-Lab/EDU-CIAA_Poncho_SumoRobot/PonchoSumoRobot.kicad_pcb

## KiCad design EDU-CIAA_Poncho_SumoRobot/PonchoSumoRobot.kicad_pcb (continued)

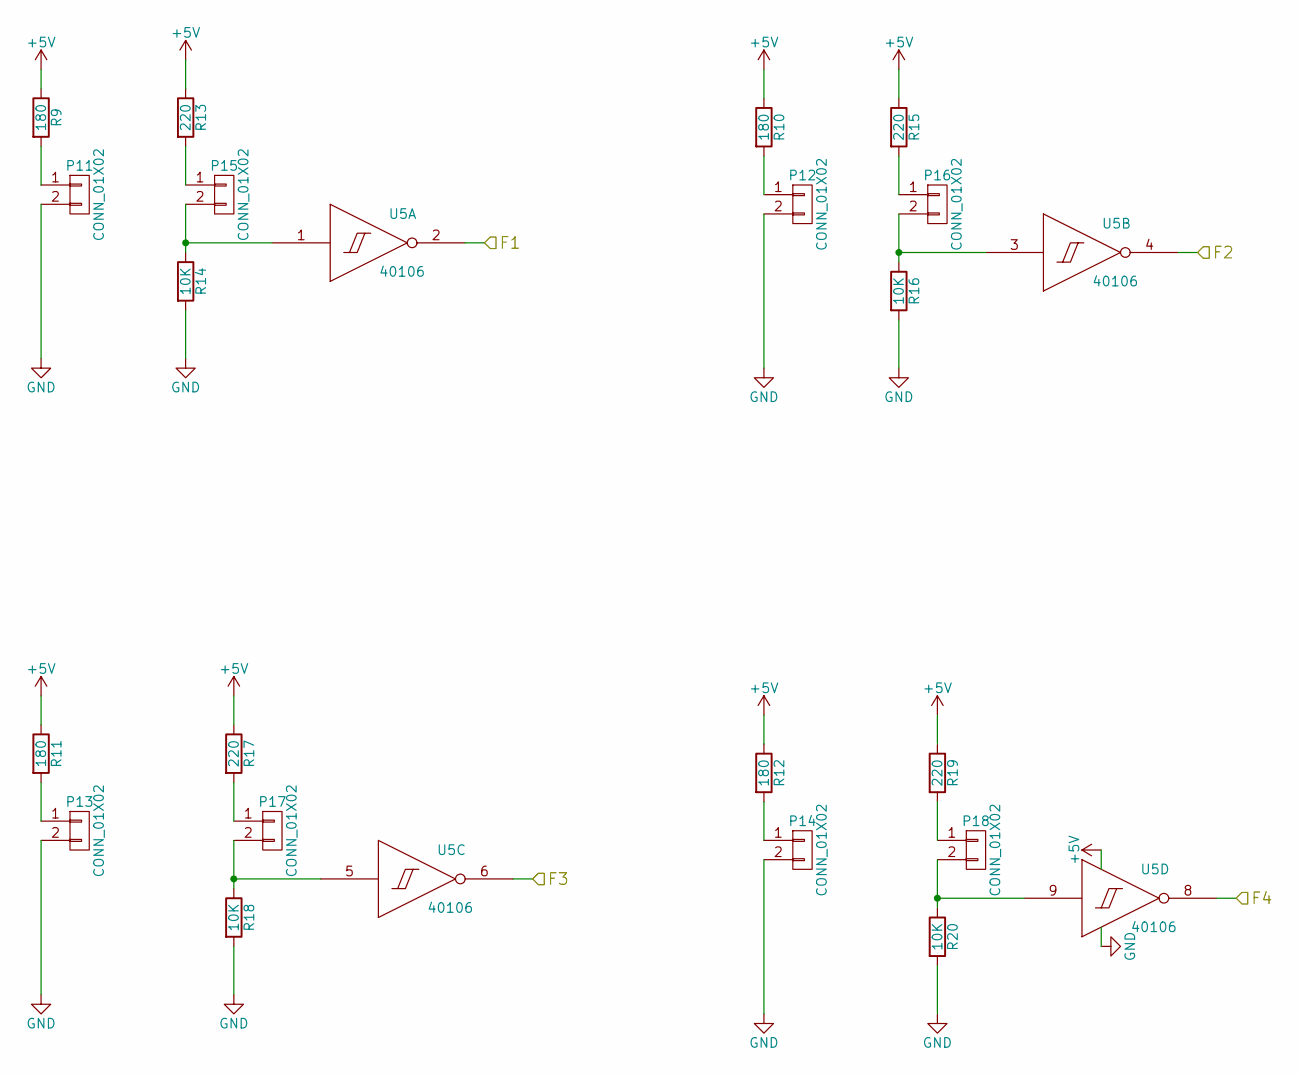
[picture p28: schematic Inflarrojos.sch]

Parts:
P11, P12, P13, P14, P15, P16, P17, P18: CONN_01X02; Pin_Header_Straight_1x02
R9, R10, R11, R12: 180; Resistor_Horizontal_RM7mm
R13, R15, R17, R19: 220; Resistor_Horizontal_RM7mm
R14, R16, R18, R20: 10K; Resistor_Horizontal_RM7mm
U5: 40106; 40xx-DIL14

Connections:
+5V: R9.1, R10.1, R11.1, R12.1, R13.1, R15.1, R17.1, R19.1, U5.14 (VDD); also elsewhere on the board
/IF/F1: U5.2 (Out); also elsewhere on the board
/IF/F2: U5.4 (Out); also elsewhere on the board
/IF/F3: U5.6 (Out); also elsewhere on the board
/IF/F4: U5.8 (Out); also elsewhere on the board
unnamed: P11.1, R9.2
unnamed: P12.1, R10.2
unnamed: P13.1, R11.2
unnamed: P14.1, R12.2
unnamed: P15.1, R13.2
unnamed: P15.2, R14.1, U5.1 (In)
unnamed: P16.1, R15.2
unnamed: P16.2, R16.1, U5.3 (In)
unnamed: P17.1, R17.2
unnamed: P17.2, R18.1, U5.5 (In)
unnamed: P18.1, R19.2
unnamed: P18.2, R20.1, U5.9 (In)

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
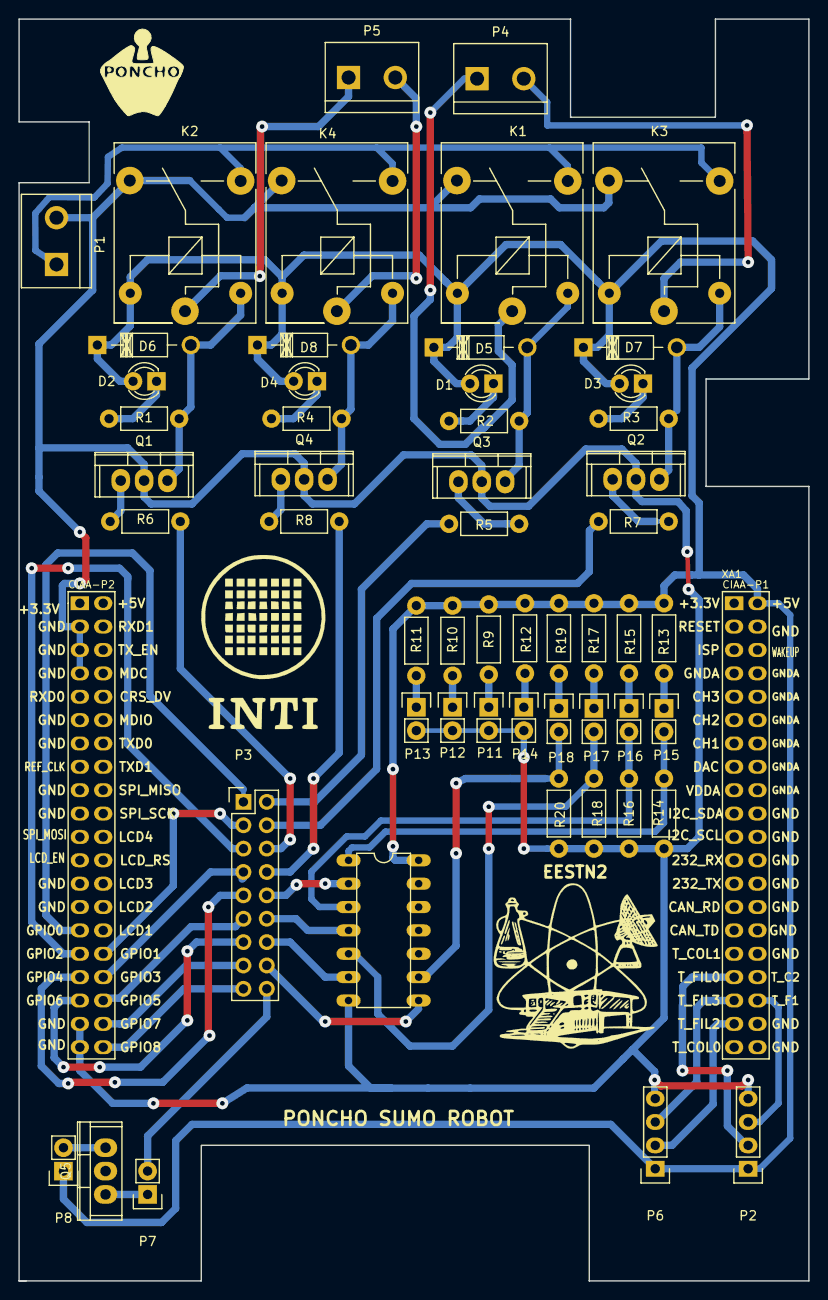
[picture p29: board PonchoSumoRobot.kicad_pcb from above]

Board: 2 copper layers, 85.9 x 137.2 mm, 56 parts (0 on the bottom side), 55 nets.

Other parts of the board:
EESTN2: EESTN2; LOGO1
