brengi/MG-Lab/(commit log)

2016-07-21 Agrego el trabajo de aplicación para acceso a laboratorio.
    [shield.kicad_pcb, shield.sch]
2016-07-21 Ordenamiento de bibliotecas y footprints.
    [shield.kicad_pcb, shield.sch]
2016-07-21 Agrego archivos del proyecto Sumo Robot con Arduino.
    [sumo.kicad_pcb, sumo.sch]
2016-07-21 Reorganizo bibliotecas del Arduino_SumoRobot.
    [sumo.kicad_pcb, sumo.sch]
2016-07-21 Agrego los archivos del Poncho Sumo Robot.
    [Inflarrojos.sch, PonchoSumoRobot.kicad_pcb, PonchoSumoRobot.sch, UltraSonido.sch]
2016-07-21 Reorganizo bibliotecas en esquemático y PCB. Reparo señal de 12V. Agrego Footprints. Coloco plantilla EDU-CIAA. Reparo asociación conector EDU-CIAA en sch y pcb.
    [Inflarrojos.sch, PonchoSumoRobot.kicad_pcb, PonchoSumoRobot.sch, UltraSonido.sch]
2016-07-21 Agrego tracking de archivo netlist.
2016-07-21 Agrego biblioteca de simbolos.
2016-07-21 Configuro directorios de impresión.
2016-07-21 Correcciones propuestas al Poncho SumoRobot.
    [Inflarrojos.sch, PonchoSumoRobot.sch, UltraSonido.sch]
2016-07-21 Modificaciones propuestas al esquemático de acceso_lab.
    [shield.sch]
2016-07-21 Sugerencias del esquemático del Arduino_sumo.
    [sumo.sch]
2016-07-21 Agrego los README,md de cada proyecto.
2016-07-21 Corrijo faltante de +5V y quito biblioteca power del Acceso_lab.
    [shield.sch]
2016-08-18 Actualizo trabajo del Poncho Sumo Robot.
    [Inflarrojos.sch, PonchoSumoRobot.kicad_pcb, PonchoSumoRobot.sch]
2016-08-23 Agrego avances y algunas correcciones propias: etiquetas 5V, serigrafía, prolijidad.
    [sumo.kicad_pcb, sumo.sch]
2016-08-24 Corrijo Dip16 a Dip14, Corrijo net 12V, Limpio placa para rerutear.
    [sumo.kicad_pcb, sumo.sch]
2016-08-24 Correcciones varias, serigrafía, ruteo, borneras, puentes, planos, etc.
    [sumo.kicad_pcb, sumo.sch]
2016-08-24 muevo una pista para achicar el borde.
    [sumo.kicad_pcb]
2016-08-24 Actualizo pcb del Arduino Acceso lab.
    [shield.kicad_pcb, shield.sch]
2016-08-24 Quito bibliotecas símbolos innecesarias.
    [shield.sch]
2016-09-08 Arduino Acceso Lab. Ultimas modificaciones al PCB.
    [shield.kicad_pcb, shield.sch]
2016-09-08 EDU-CIAA Poncho Sumo Robot. Ultimos cambios de vías y puentes para simple faz.
    [PonchoSumoRobot.kicad_pcb, PonchoSumoRobot.sch]
2016-09-08 Arduino_Acceso_lab/firmware ultimos agregados.
2016-09-08 Agrego prueba del shield de Sumo Robot para Arduino.
2016-11-02 Primer borrador de la versión 2 de la placa Arduino Sumo.
    [sumo.kicad_pcb, sumo.sch]
2016-11-02 Cambios en el esquemático y asignación de huellas dentro del proyecto.
    [sumo.sch]
2016-11-02 Agrego huellas adicionales al arduino-sumo.
2016-11-02 Cambios significativos en el PCB arduino sumo. desruteo. reorganización de componentes. reglas de diseño.
    [sumo.kicad_pcb]
2016-11-02 Arduino Sumo. Cambio todos los leds a 3mm porque había una mezcla.
    [sumo.kicad_pcb, sumo.sch]
2016-11-03 Anoto correcciones al Poncho Sumo.
    [PonchoSumoRobot.kicad_pcb]
2016-11-08 Agrego version Expo del módulo wifi con Arduino Mega.
    [pcb.kicad_pcb, pcb.sch]
2016-11-08 Versión corregida por DJB del Shield Wifi para Arduini Mega.
    [pcb.kicad_pcb, pcb.sch]
2016-11-08 Detalles Arduino Mega Wifi Shield.
    [pcb.kicad_pcb]
2016-11-14 Agregado de fotos grupales.
2016-11-14 Agrego mejoras al shield para acceso lab.
    [shield.sch]
2016-11-14 Nuevo PCB.
    [shield.kicad_pcb]
2016-11-14 Detalles pcb acceso arduino lab.
    [shield.kicad_pcb, shield.sch]
2016-11-14 Agrego power flags y quito lib rescue.
    [shield.sch]
2016-12-20 Agrego reporte de Acceso Lab Grupo 2.
2016-12-20 Agrego avances en el PCB de Acceso Lab.
    [shield.kicad_pcb, shield.sch]
2016-12-20 Agrego mejoras al Arduino Sumo Robot realizadas por el Grupo II de 2016.
    [sumo.kicad_pcb, sumo.sch]
2017-12-06 Agrego el anteúltimo grupo.
2017-12-06 Correcciones de año.
2019-07-31 Agrego placa rolador con modificaciones DJB
    [placa de tension rolador-2019-06-21-08-11-12.sch, placa de tension rolador.dsn, placa de tension rolador.kicad_pcb, placa de tension rolador.sch]
2019-10-07 Se agrega el directorio Boton_Auxilio con lo desarrollado en la turoria en el manejo del ESP32 y el servicio de internet IFTTT, junto con el diagrama en bloques basic del proyecto.
2019-10-07 se eliminar los archivos .zip del directorio ESP32_Module/Libreries
